petegaggs/NC_Mini_Synth/README.md

# NC_Mini_Synth
A self contained mini-synth controlled by arduino, with numerically controlled oscillator
