petegaggs/NC_Mini_Synth/NC Mini Synth BOM rev B.xlsx

Sheet: Main Board
Description | Designator | Footprint | Quantity | Manufacturer Part | Manufacturer
NC Mini-synth Bill of Materials
REV B
Semiconductors
Transistor PNP 2N3906 | Q1,Q2,Q6,Q7,Q8,Q4,Q5,Q11 | TO-92 | 8 | 2N3906
Transistor NPN 2N3904 | Q9,Q10,Q3 | TO-92 | 3 | 2N3904
LED White 5mm | LED1,LED2 | LED-DIP-5.8MM | 2
IC LMC7660IN/NOPB Switched Capacitor Voltage Converter | U2 | DIP-8 | 1 | LMC7660IN/NOPB | TI
IC 6N139 Opto Isolator | U4 | DIP-8 | 1 | 6N139 | FAIRCHILD
Diode Shottky 1N5817 | D1 | DO-41 | 1 | 1N5817
Diode 1N4148 | D2 | DO-35 | 1 | 1N4148
IC Voltage Regulator +5V 78L05 TO-92 | U1 | TO-92 | 1 | MC78L05ACPG | ON SEMI
ATMEGA328P-PU | U3 | DIP-28/300MIL | 1 | ATMEGA328P-PU | ATMEL
IC Dual Transconductance Amplifier LM13700 | U9,U10 | DIP-16 | 2 | LM13700N/NOPB | TI
IC Quad Op-amp LM324N | U7,U5 | DIP-14 | 2 | LM324N/NOPB | TI
IC Dual Op-amp LM358N | U8 | DIP-8 | 1 | LM358N/NOPB | TI
Capacitors
Capacitor ceramic 22pF 50V NPO 10% | C11,C7 | RAD-0.1 | 2
Capacitor 4.7nF 100V Wima FKP2 Polypropylene 10% | C26,C39 |  | 2
Capacitor 3.3nF 100V Wima FKP2 Polypropylene 10% | C25 |  | 1
Capacitor 1nF 100V Wima FKP Polypropylene 10% | C33,C34,C35 |  | 3
Capacitor 15nF 63V Wima MKS2 PET 10% | C14,C18 |  | 2
Capacitor Ceramic 100nF radial 0.1” pitch | C27,C28,C29,C30,C31,C32,C4,C5,C6,C9,C38,C21,C22,C12,C13 |  | 15
Capacitor Electrolytic Non-Polar 10uF 50V 5x11 | C36,C23,C24,C37 | 5x11 | 4
Capacitor Electrolytic 100uF 16V 85 degree 6.3x11 | C1,C8,C2,C3 | 6.3x11 | 4
Capacitor 330pF 100V Wima FKP Polypropylene 10% | C19 |  | 1
Capacitor 100nF 100V Wima MKS2 Polyester 10% | C20 |  | 1
Capacitor Electrolytic 4.7uF 25V 85 degree 5x11 2mm pitch | C10 |  | 1
Crystals
Crystal HC-49 16.000MHz low profile | Y1 | HC49US | 1
Resistors
Resistor Metal Film 1/4W 1% 220R | R28,R29,R36,R37,R42,R43,R1,R49,R51,R55 | AXIAL-0.4 | 10
Resistor Metal Film 1/4W 1% 270R | R8 | AXIAL-0.4 | 1
Resistor Metal Film 1/4W 1% 330R | R2 | AXIAL-0.4 | 1
Resistor Metal Film 1/4W 1% 1K8 | R25,R46 | AXIAL-0.4 | 2
Resistor Metal Film 1/4W 1% 2K2 | R7,R27,R33,R38,R45,R13 | AXIAL-0.4 | 6
Resistor Metal Film 1/4W 1% 4K7 | R31,R39,R44,R12,R53 | AXIAL-0.4 | 5
Resistor Metal Film 1/4W 1% 5K6 | R48 | AXIAL-0.4 | 1
Resistor Metal Film 1/4W 1% 10K | R30,R32,R34,R35,R40,R41,R47,R3,R19,R52 | AXIAL-0.4 | 10
Resistor Metal Film 1/4W 1% 18K | R17 | AXIAL-0.4 | 1
Resistor Metal Film 1/4W 1% 22K | R4,R18 | AXIAL-0.4 | 2
Resistor Metal Film 1/4W 1% 33K | R50 | AXIAL-0.4 | 1
Resistor Metal Film 1/4W 1% 47K | R11 | AXIAL-0.4 | 1
Resistor Metal Film 1/4W 1% 68K | R9 | AXIAL-0.4 | 1
Resistor Metal Film 1/4W 1% 100K | R23,R24,R14,R15,R5,R6,R20,R21,R54 | AXIAL-0.4 | 9
Resistor Metal Film 1/4W 1% 150K | R10 | AXIAL-0.4 | 1
Resistor Metal Film 1/4W 1% 220K | R16 | AXIAL-0.4 | 1
Resistor Metal Film 1/4W 1% 470K | R26 | AXIAL-0.4 | 1
Resistor Metal Film 1/4W 1% 1M5 | R22 | AXIAL-0.4 | 1
Connectors
Header Male 0.1” pitch single row 2 way | P3 |  | 1
Header Male 0.1” pitch single row 6 way | P4 |  | 1

Sheet: Other parts
Other parts needed, not on main board
Description | Function | Quantity
DC Power Jack 2.1mm Panel Mount Bulkhead | Power in DC 9V | 1
10K OHM Logarithmic Taper Potentiometer 16mm | Noise level, Saw wave level, Pulse wave level | 3
100K OHM Logarithmic Taper Potentiometer 16mm | Filter resonance | 1
10K OHM Linear Taper Potentiometer 16mm | LFO wave, LFO speed, PWM, PW | 4
47K OHM Linear Taper Potentiometer 16mm | Filter freq, Filter LFO level | 2
500K OHM Linear Taper Potentiometer 16mm | Attack, Release | 2
5-Pin DIN Socket, panel mount | MIDI in | 1
6.35mm 1/4" Mono Chassis Socket | Audio out | 1
Knobs | for pots | 12
Case Hammond 1590XX 145x121x39mm
