petegaggs/NC_Mini_Synth/NC Mini Synth Schematic Rev B.pdf

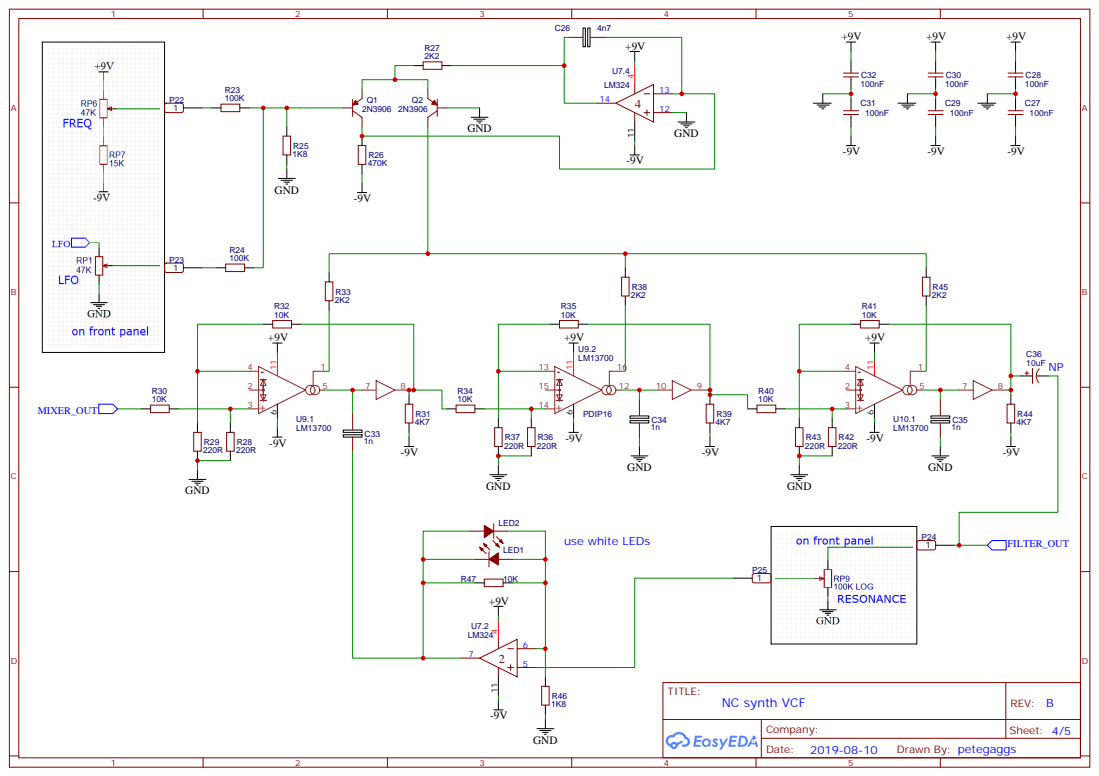
[picture p1: page 1]

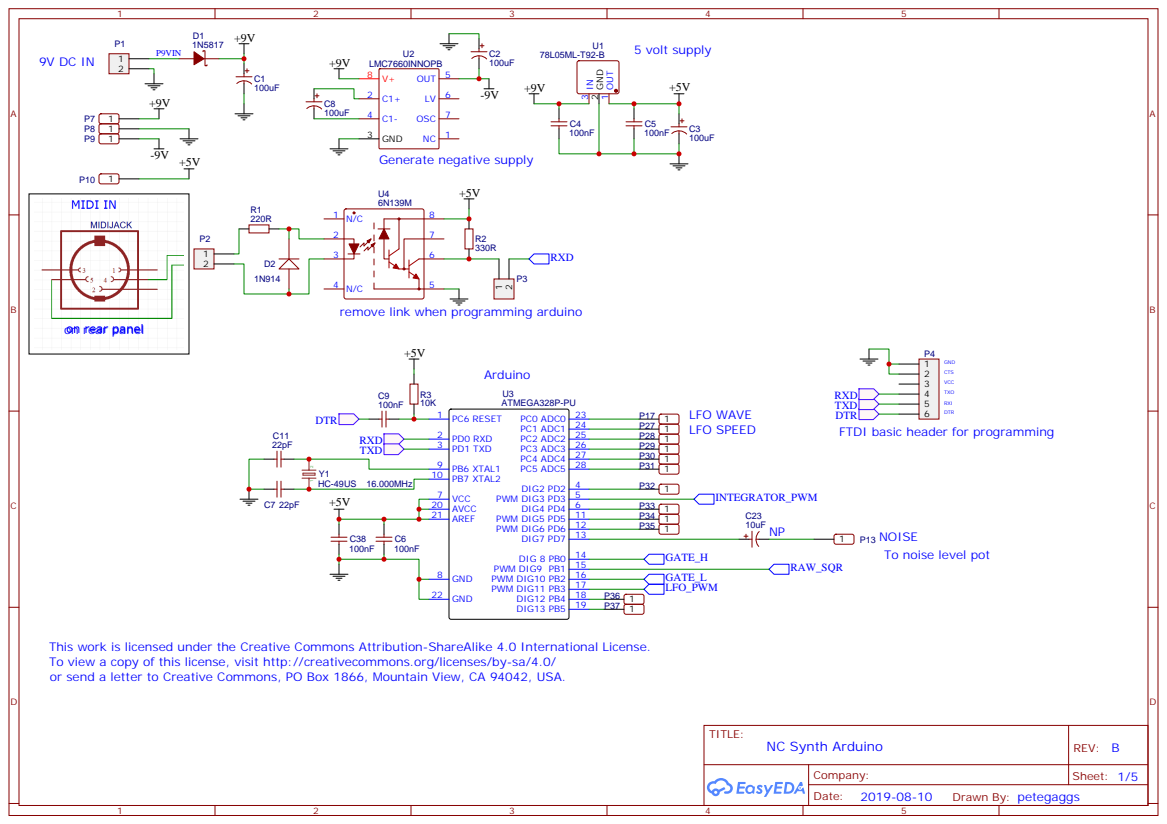
[picture p2: page 2]

remove link when programming arduino

RXD
TXD
DTR
FTDI basic header for programming

NOISE
To noise level pot

This work is licensed under the Creative Commons Attribution-ShareAlike 4.0 International License.
To view a copy of this license, visit http://creativecommons.org/licenses/by-sa/4.0/
or send a letter to Creative Commons, PO Box 1866, Mountain View, CA 94042, USA.

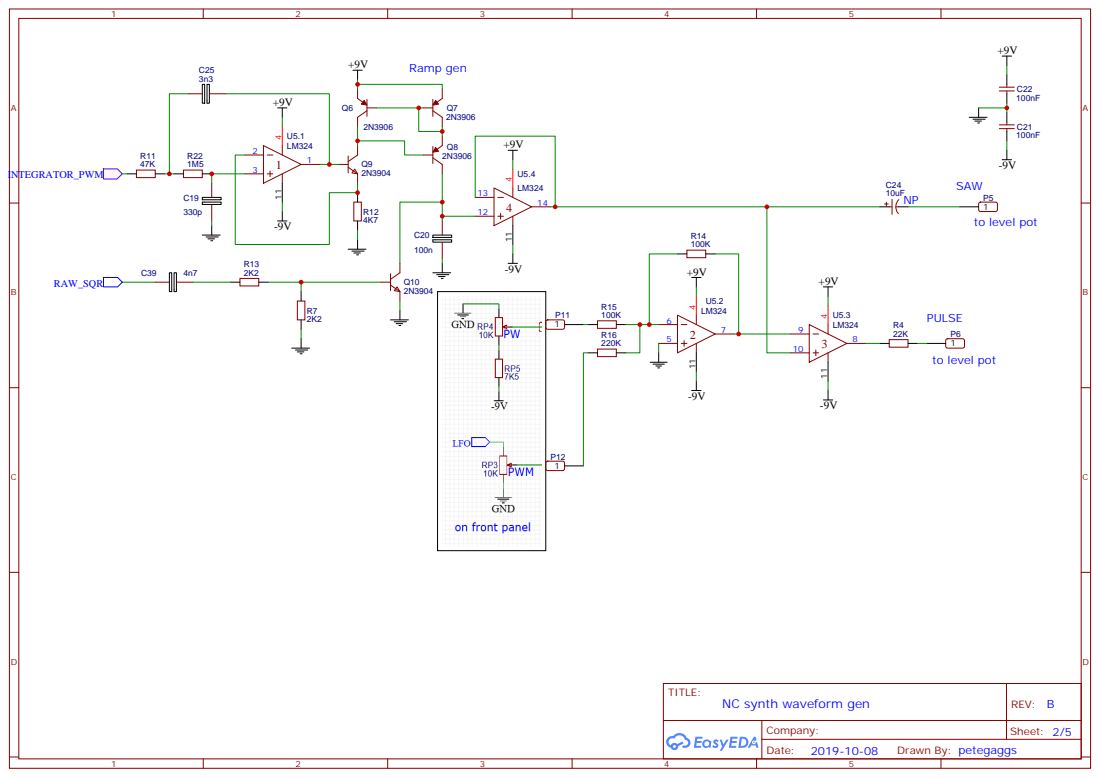
[picture p3: page 3]

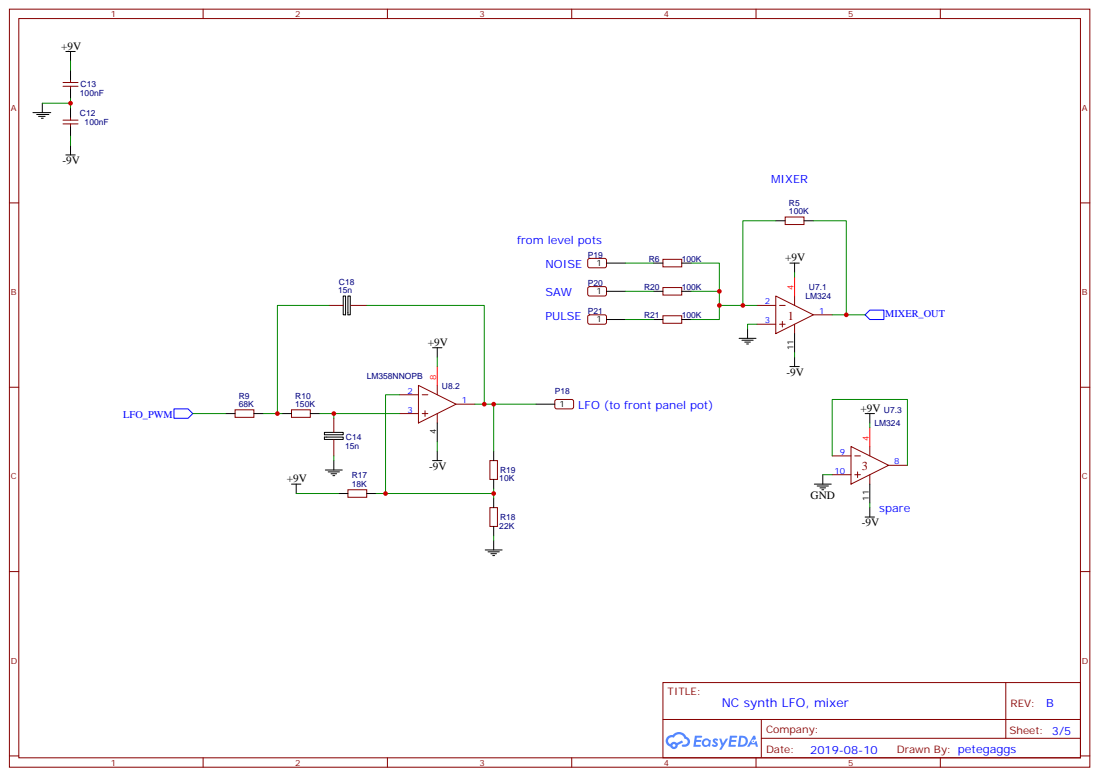
[picture p4: page 4]

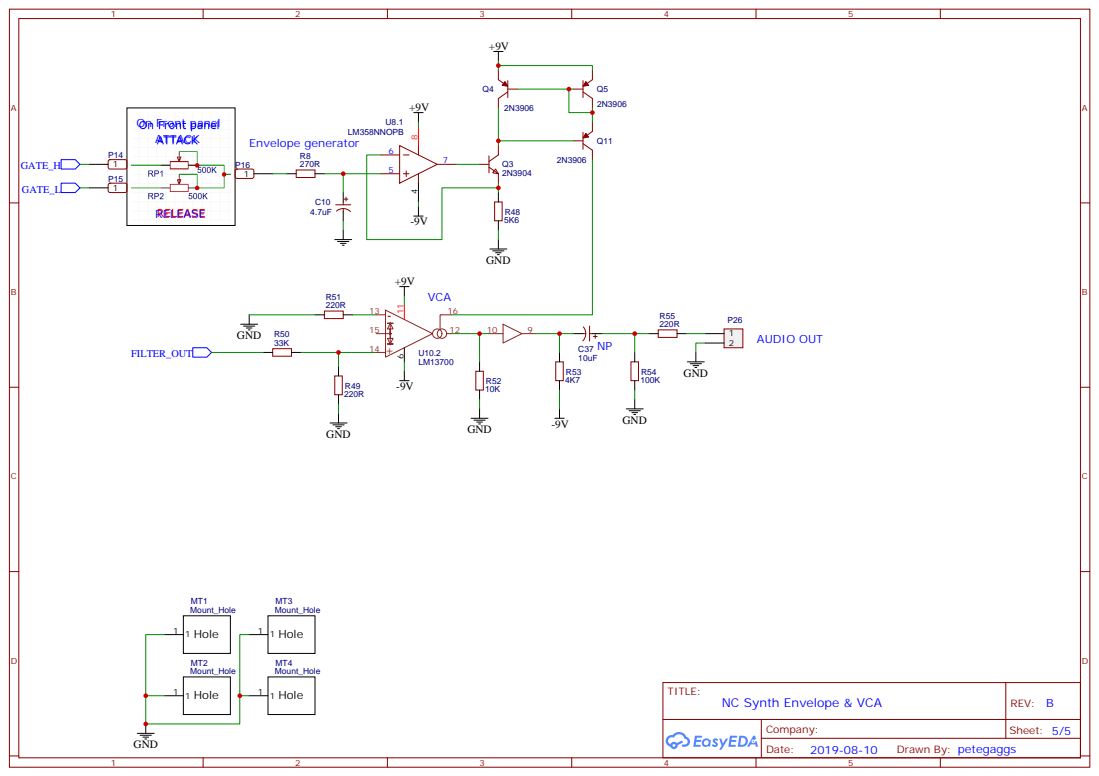
[picture p5: page 5]
