petegaggs/NC_Mini_Synth/(commit log)

2019-07-20 Add files via upload
    added dither to pwm for better resolution at low note frequencies
2019-08-01 Add files via upload
    bodge for pwm issue
    [nc_minisynth.ino]
