petegaggs/NC_Mini_Synth/(notices)

Notices in the files:
nc_minisynth.ino:
MIT License
Copyright (c) 2019 petegaggs
